Upcycle-Electronics/CH341A-Pro/README.md

# CH341A-Pro

Schematic:
https://github.com/Upcycle-Electronics/CH341A-Pro/blob/master/ch341Apro_schematicV01.pdf

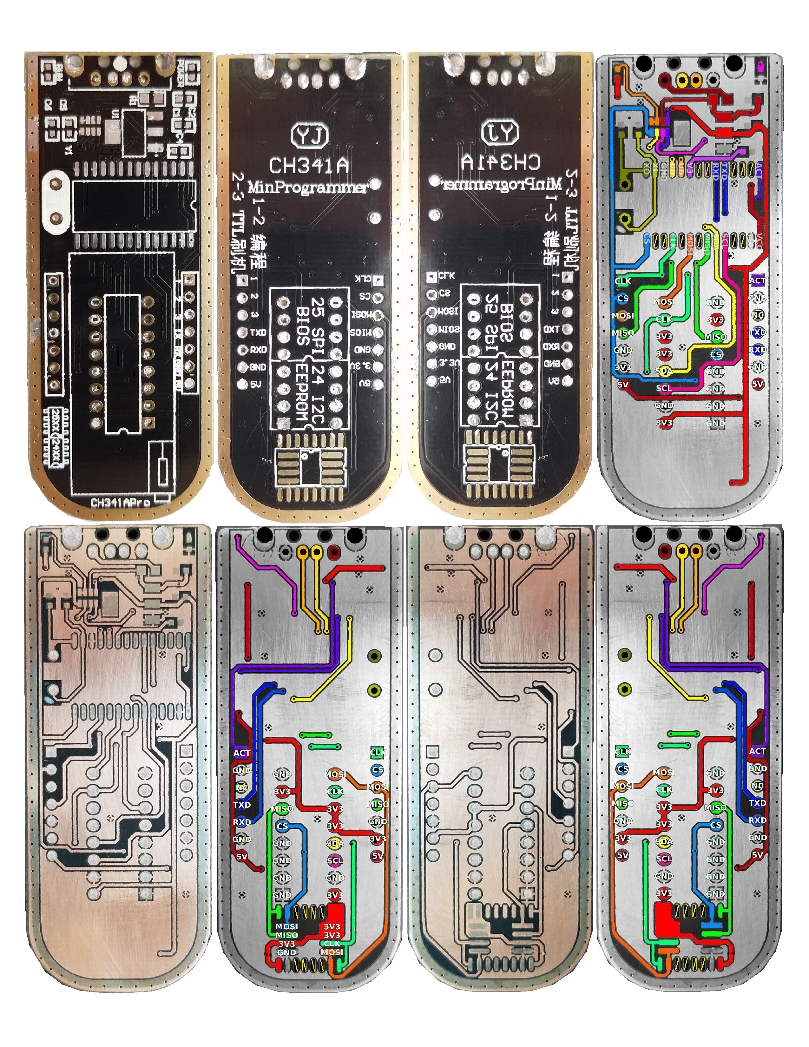
[picture p1: ch341aProB+.jpeg]
V1
