Upcycle-Electronics/CH341A-Pro/ch341aProMain.jpeg

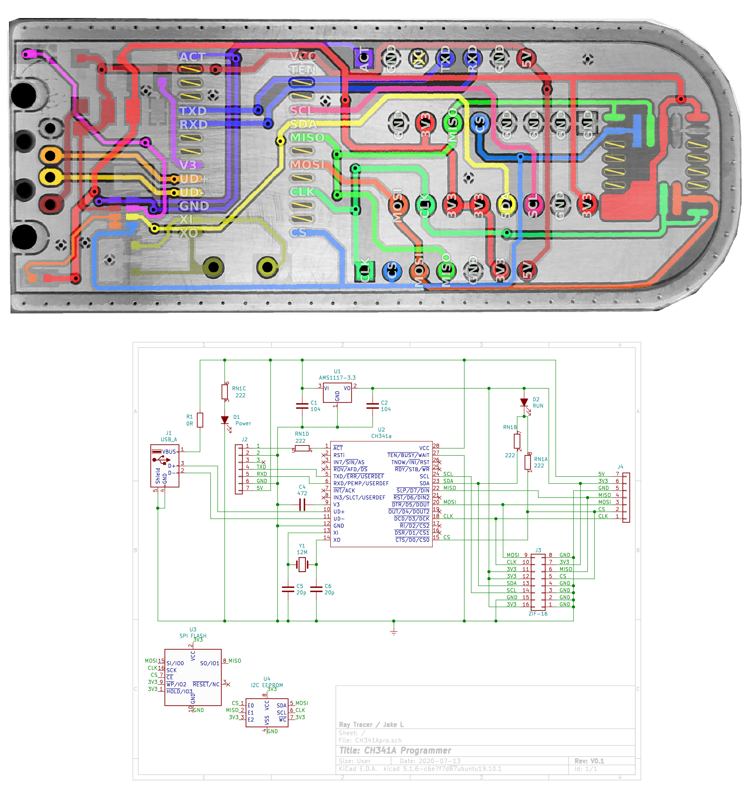
ch341aProMain.jpeg
