Upcycle-Electronics/CH341A-Pro/ch341Apro_schematicV01.pdf

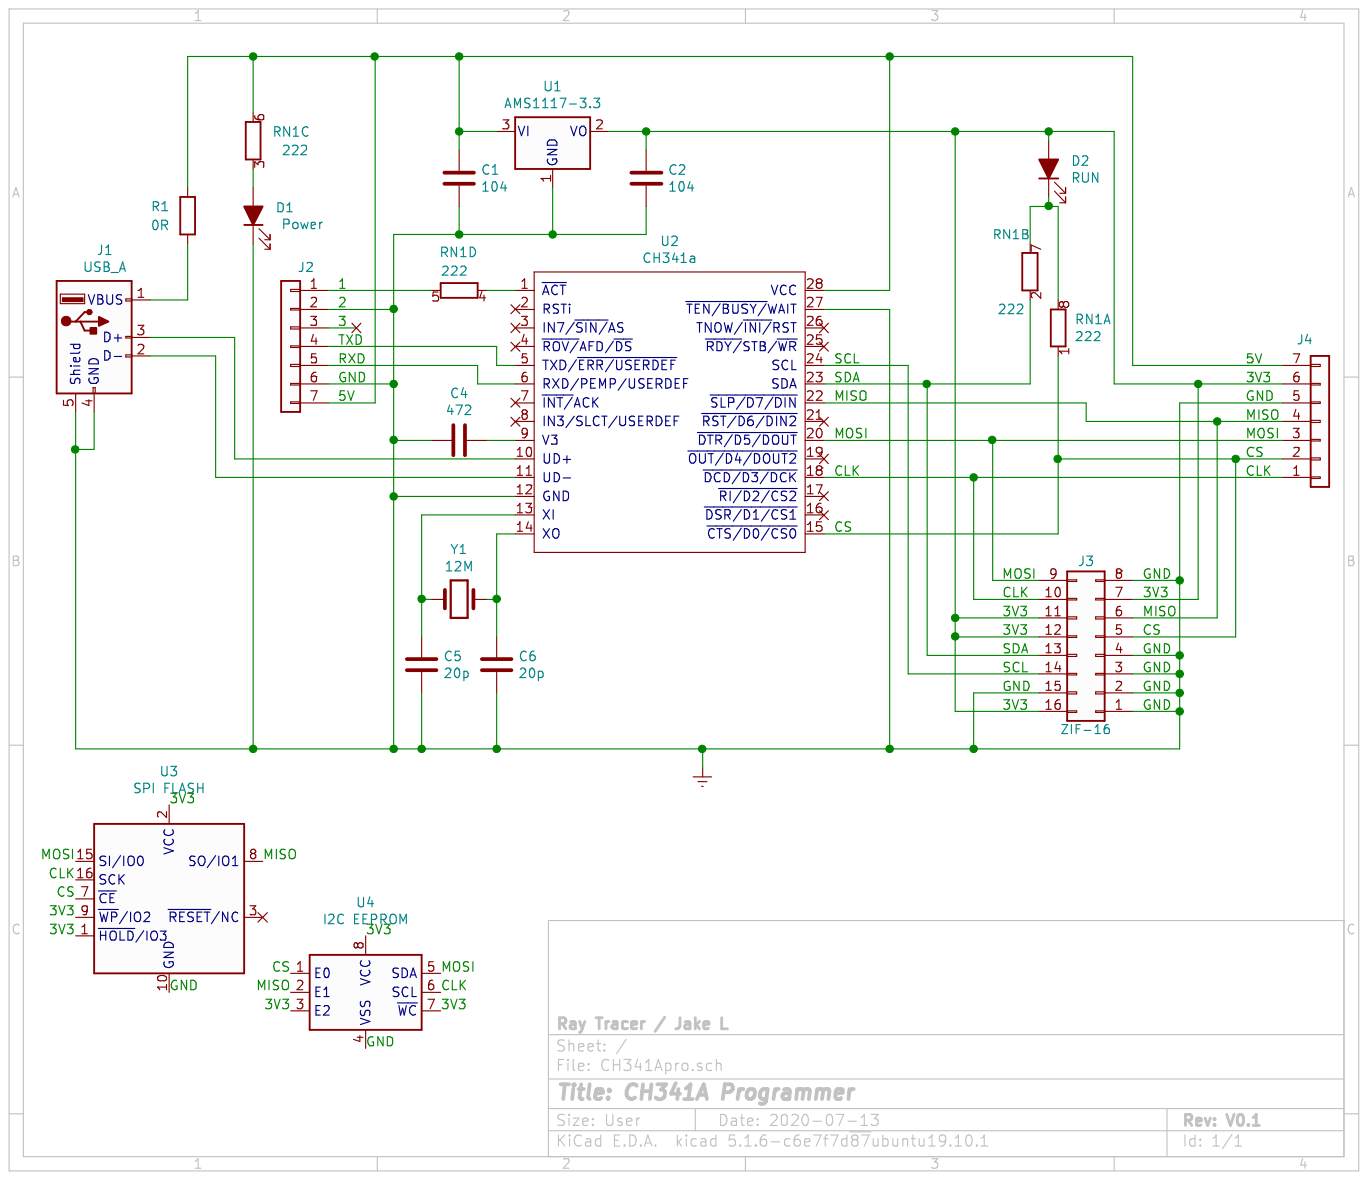
[picture p3: page 1]
