Upcycle-Electronics/CH341A-Pro/CH341Apro.kicad_pcb

## KiCad design CH341Apro.kicad_pcb (2020-07-14)

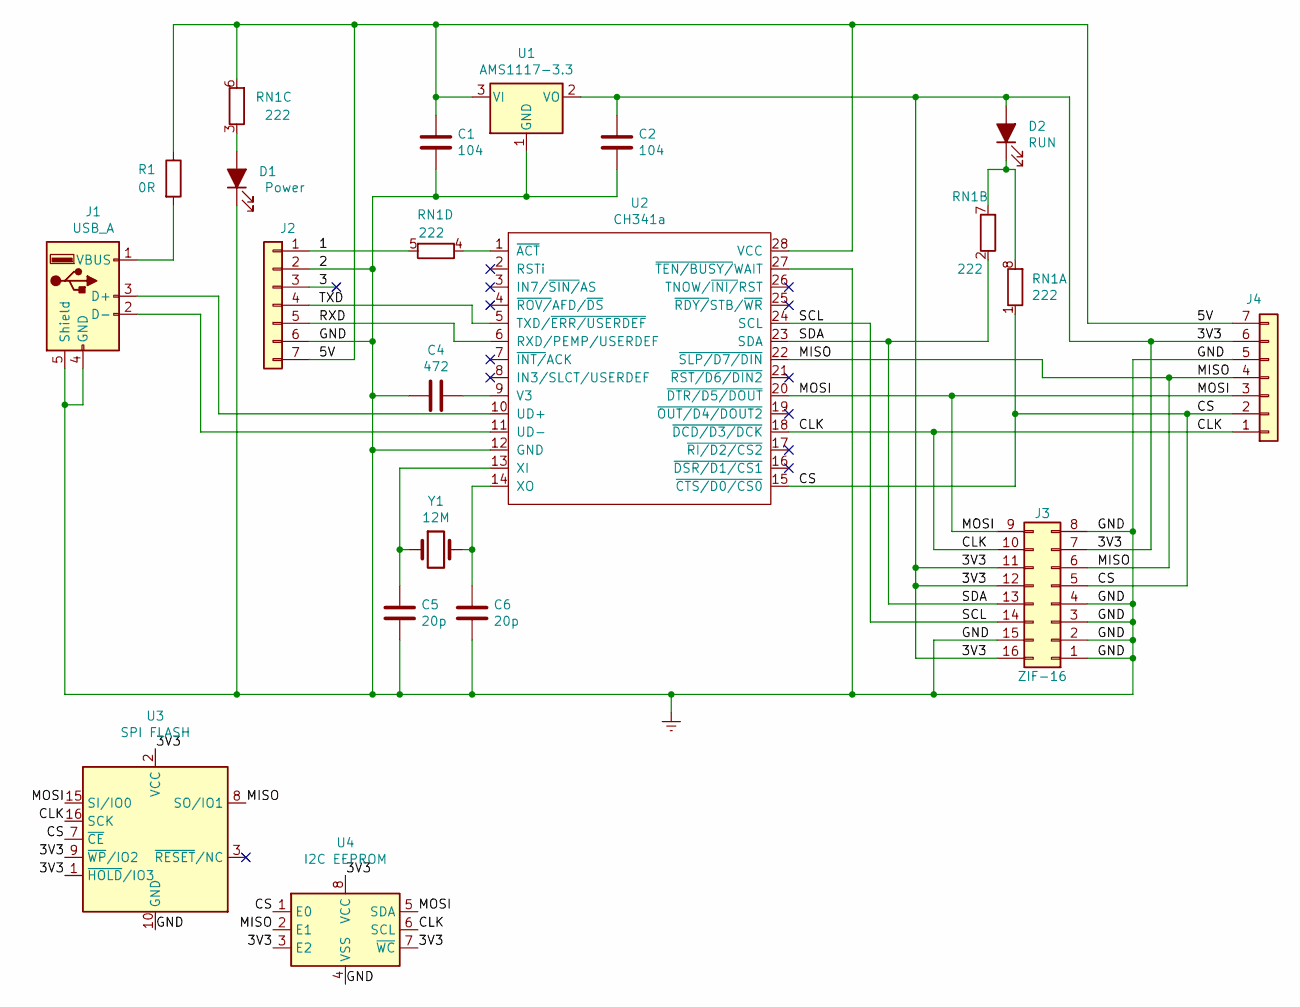
[picture p4: schematic CH341Apro.sch, CH341A Programmer]

Parts:
C1, C2: 104; C_0603_1608Metric
C4: 472; C_0603_1608Metric
C5, C6: 20p; C_0603_1608Metric
D1: Power; LED_0603_1608Metric
D2: RUN; LED_0603_1608Metric
J1: USB_A; USB_A_MALE_Generic
J2, J4: Conn_01x07; PinSocket_1x07_P2.54mm_Vertical
J3: ZIF-16; DIP_Socket-16_W4.3_W5.08_W7.62_W10.16_W10.9_3M_216-3340-00-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
R1: 0R; R_0805_2012Metric
RN1: 222; R_Array_Convex_4x0603
U1: AMS1117-3.3; SOT-223-3_TabPin2
U2: CH341a; SOIC-28W_7.5x17.9mm_P1.27mm
U3: SPI FLASH; SOIC-16W_7.5x10.3mm_P1.27mm
U4: I2C EEPROM; SOIC-8_3.9x4.9mm_P1.27mm
Y1: 12M; Crystal_HC49-U_Vertical

Connections:
/1: J2.1, RN1.5 (R4.2)
/3: J2.3
/3V3: C2.1, D2.2 (A), J3.7, J3.11, J3.12, J3.16, J4.6, U1.2 (VO), U3.1 (~HOLD~/IO3), U3.2 (VCC), U3.9 (~WP~/IO2), U4.3 (E2), U4.7 (~WC), U4.8 (VCC)
/5V: C1.1, J2.7, J4.7, R1.1, RN1.6 (R3.2), U1.3 (VI), U2.28 (VCC)
/CLK: J3.10, J4.1, U2.18 (~DCD/D3/DCK), U3.16 (SCK), U4.6 (SCL)
/CS: J3.5, J4.2, RN1.1 (R1.1), U2.15 (~CTS/D0/CS0), U3.7 (~CE), U4.1 (E0)
/MISO: J3.6, J4.4, U2.22 (~SLP/D7/DIN), U3.8 (SO/IO1), U4.2 (E1)
/MOSI: J3.9, J4.3, U2.20 (~DTR/D5/DOUT), U3.15 (SI/IO0), U4.5 (SDA)
/RXD: J2.5, U2.6 (RXD/PEMP/USERDEF)
/SCL: J3.14, U2.24 (SCL)
/SDA: J3.13, RN1.2 (R2.1), U2.23 (SDA)
/TXD: J2.4, U2.5 (TXD/~ERR/USERDEF)
Earth: C1.2, C2.2, C4.2, C5.2, C6.2, D1.1 (K), J1.4 (GND), J1.5 (Shield), J2.2, J2.6, J3.1, J3.2, J3.3, J3.4, J3.8, J3.15, J4.5, U1.1 (GND), U2.12 (GND), U2.27 (~TEN/BUSY/~WAIT), U3.10 (GND), U4.4 (VSS)
unnamed: C4.1, U2.9 (V3)
unnamed: C5.1, U2.13 (XI), Y1.1
unnamed: C6.1, U2.14 (XO), Y1.2
unnamed: D1.2 (A), RN1.3 (R3.1)
unnamed: D2.1 (K), RN1.7 (R2.2), RN1.8 (R1.2)
unnamed: J1.1 (VBUS), R1.2
unnamed: J1.2 (D-), U2.11 (UD-)
unnamed: J1.3 (D+), U2.10 (UD+)
unnamed: RN1.4 (R4.1), U2.1 (~ACT)

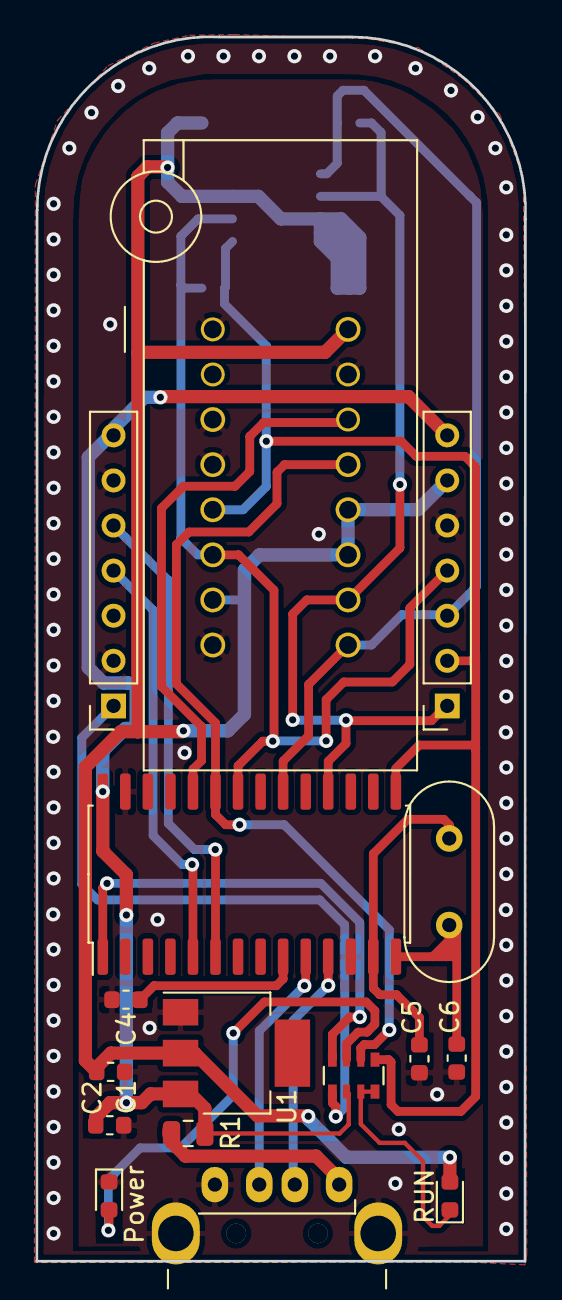
[picture p5: board CH341Apro.kicad_pcb from above]

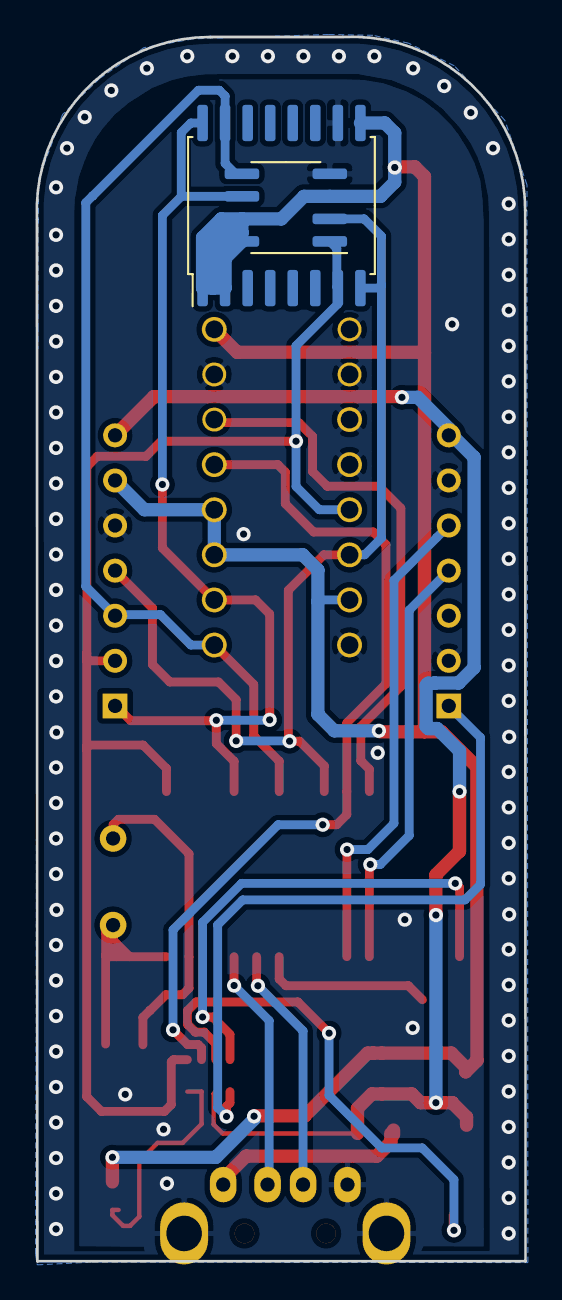
[picture p6: board CH341Apro.kicad_pcb from below]

Board: 2 copper layers, 27.5 x 69.0 mm, 18 parts (2 on the bottom side), 21 nets.
